lakshmianand07/IoT-based-Industrial-Motor-Predictive-Maintenance-Sytem/(commit log)

2026-11-03 Revise README for Motor Predictive Maintenance System
    Expanded project details, hardware components, software technologies, working principles, features, future improvements, applications, author information, and acknowledgements.
2026-11-03 Add motor predictive maintenance monitoring system
    This file implements a vibration monitoring system using an MPU6050 sensor and uploads data to ThingSpeak.
    [motor_predictive_maintenance.ino]
